tolgakurt/esp01-dual-relay/pcb/esp.brd

## EAGLE design pcb/esp.brd (2019-05-07)

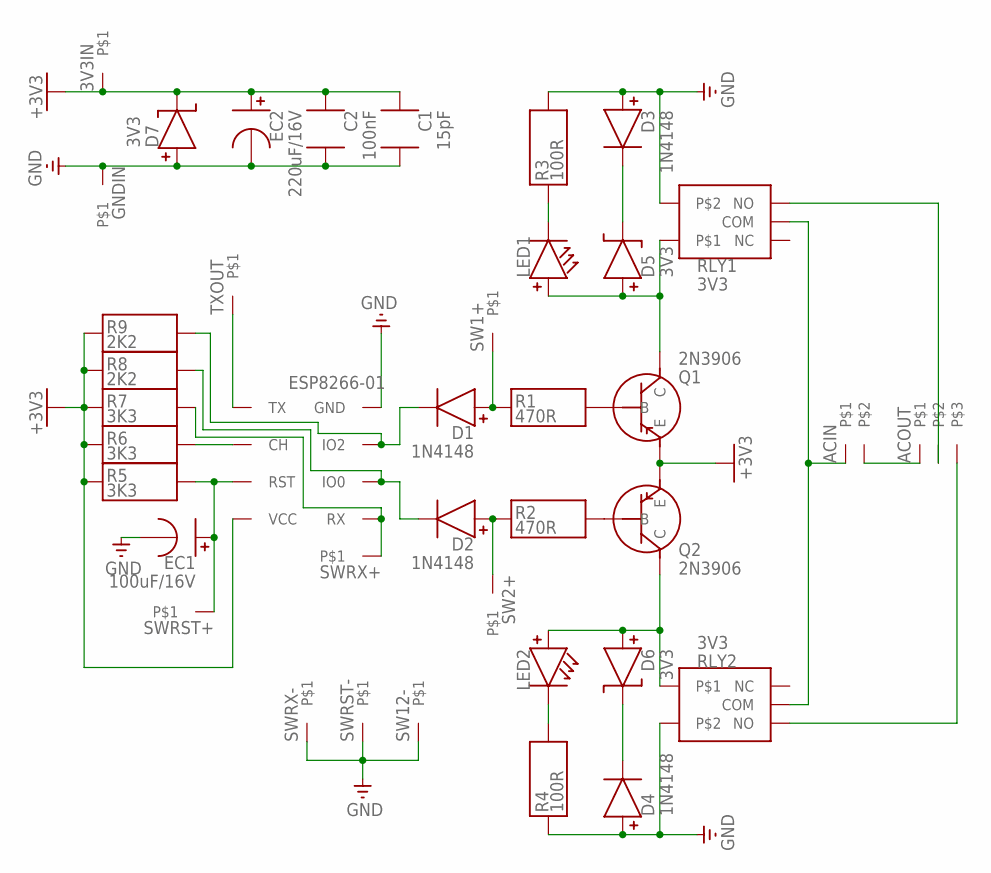
[picture p11: schematic esp.sch]

Parts:
3V3IN: CON1PINPLUG1; PINPLUG1
ACIN: CON2CON5.0S2T; CON5.0S2T
ACOUT: CON3CON5.0S3T; CON5.0S3T
C1: 15pF; CERCAP3.2S
C2: 100nF; CERCAP5.6S
D1, D2, D3, D4: 1N4148; RD5.0S1.8D
D5, D6, D7: 3V3; ZD6.0S2.0D
EC1: 100uF/16V; ECAP3.2S5.0D
EC2: 220uF/16V; ECAP3.2S5.0D
ESP8266-01: ESP8266E01ESP8266E01; ESP8266E01
GNDIN: CON1PINPLUG1; PINPLUG1
LED1, LED2: LEDLED3.2S5.0D; LED3.2S5.0D
Q1, Q2: 2N3906; TO92
R1, R2: 470R; HOR.25W
R3, R4: 100R; HOR.25W
R5, R6, R7: 3K3; HOR.25W
R8, R9: 2K2; HOR.25W
RLY1, RLY2: 3V3; RLY15W19L
SW1+, SW2+, SW12-: CON1PINPLUG1; PINPLUG1
SWRST+: CON1PINPLUG1; PINPLUG1
SWRST-: CON1PINPLUG1; PINPLUG1
SWRX+: CON1PINPLUG1; PINPLUG1
SWRX-: CON1PINPLUG1; PINPLUG1
TXOUT: CON1PINPLUG1; PINPLUG1

Connections:
+3V3: 3V3IN.P$1, C1.P$1, C2.P$1, D7.P-, EC2.P+, ESP8266-01.VCC, Q1.3 (E), Q2.3 (E), R5.P$1, R6.P$1, R7.P$1, R8.P$1, R9.P$1
GND: C1.P$2, C2.P$2, D3.P+, D4.P+, D7.P+, EC1.P-, EC2.P-, ESP8266-01.GND, GNDIN.P$1, R3.P$2, R4.P$1, RLY1.P$2, RLY2.P$2, SW12-.P$1, SWRST-.P$1, SWRX-.P$1
unnamed: LED2.P-, R4.P$2
unnamed: ESP8266-01.CH, R6.P$2
unnamed: ESP8266-01.RX, R7.P$2, SWRX+.P$1
unnamed: Q1.2 (B), R1.P$2
unnamed: D1.P+, R1.P$1, SW1+.P$1
unnamed: D2.P-, ESP8266-01.IO0, R8.P$2
unnamed: D6.P+, LED2.P+, Q2.1 (C), RLY2.P$1
unnamed: LED1.P-, R3.P$1
unnamed: D4.P-, D6.P-
unnamed: EC1.P+, ESP8266-01.RST, R5.P$2, SWRST+.P$1
unnamed: ACOUT.P$3, RLY2.NO
unnamed: D5.P+, LED1.P+, Q1.1 (C), RLY1.P$1
unnamed: ESP8266-01.TX, TXOUT.P$1
unnamed: D3.P-, D5.P-
unnamed: ACOUT.P$2, RLY1.NO
unnamed: ACIN.P$2, ACOUT.P$1
unnamed: Q2.2 (B), R2.P$2
unnamed: D2.P+, R2.P$1, SW2+.P$1
unnamed: ACIN.P$1, RLY1.COM, RLY2.COM
unnamed: D1.P-, ESP8266-01.IO2, R9.P$2

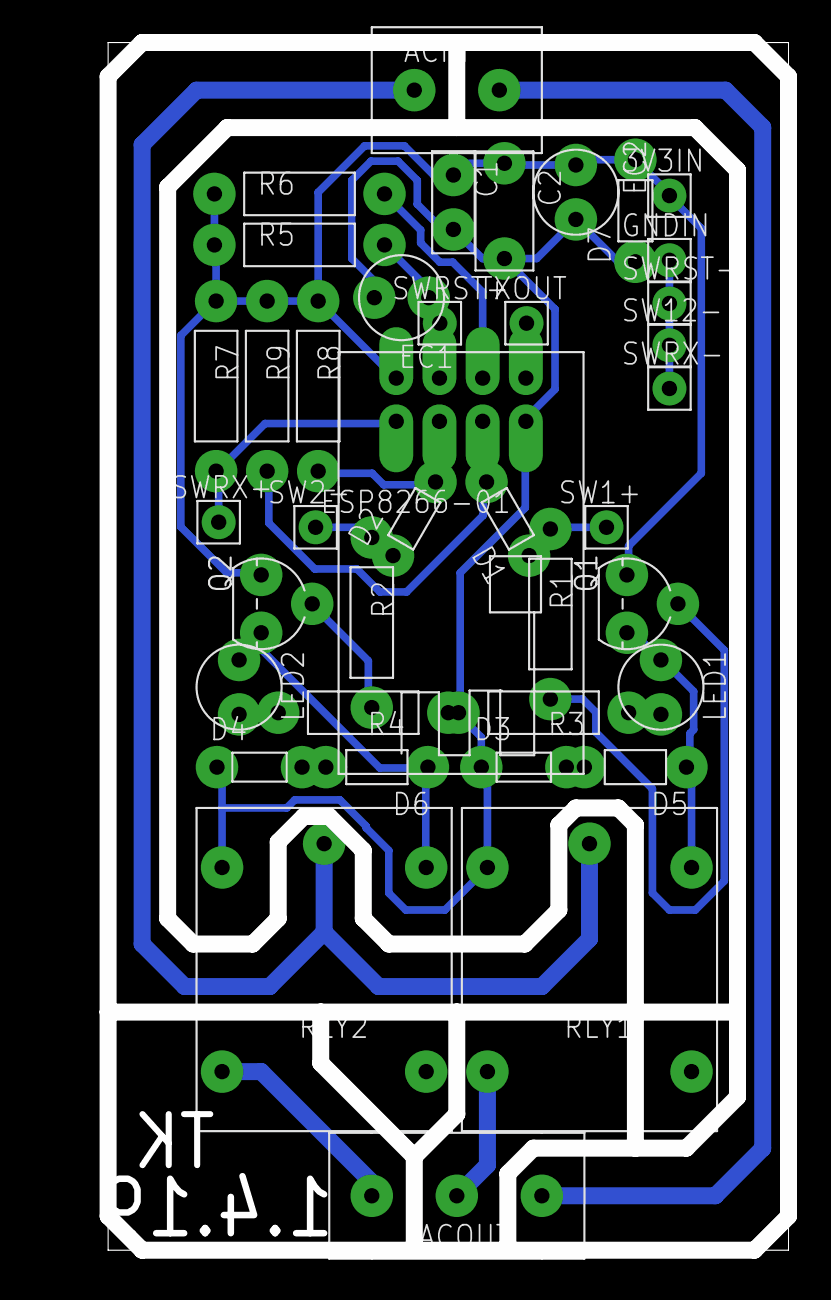
[picture p12: board esp.brd from above]

Board: 2 copper layers, 40.0 x 71.0 mm, 39 parts (0 on the bottom side), 22 nets.
