tolgakurt/esp01-dual-relay/(commit log)

2018-12-18 Update README. Add gcode files. Add EAGLE model files. Add pictures.
    [esp.brd, esp.sch]
2019-05-07 Remove ignored EAGLE files. Separate the README files. Renew circuit schematic and board images.
    [esp.brd, esp.sch]
2019-05-11 Add PWA frontend that is used to manage the devices from a browser and related README.
2020-03-12 Add a completely different side project: Arduino + DS1302 RTC + 16x2 LED Screen based, non-connecting control module.
